netl/serial-charger/pcb/output/layout.pdf

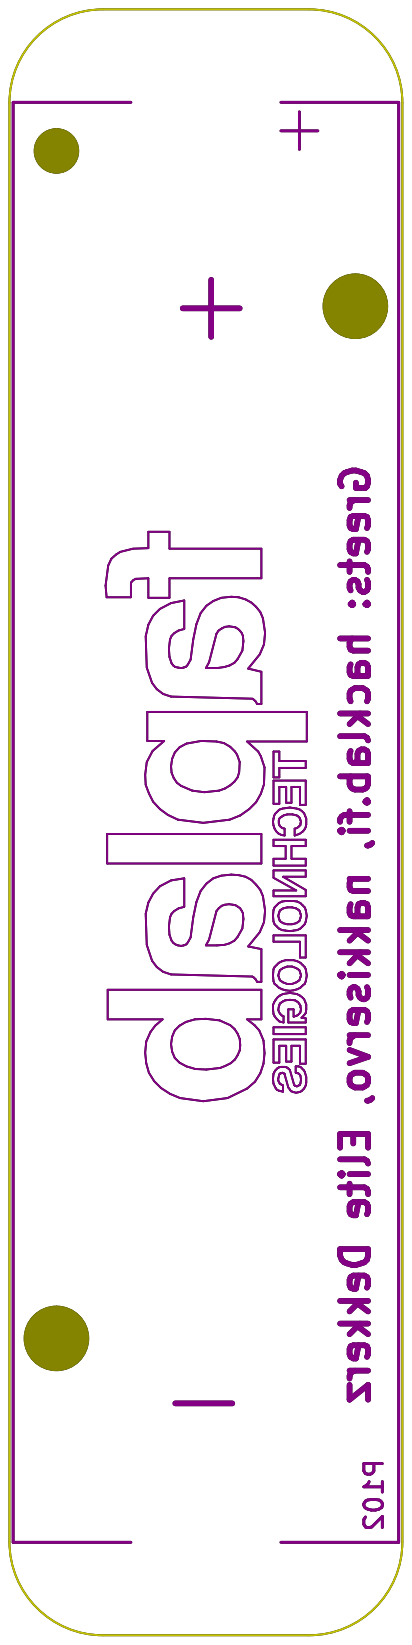
[picture p5: page 1]

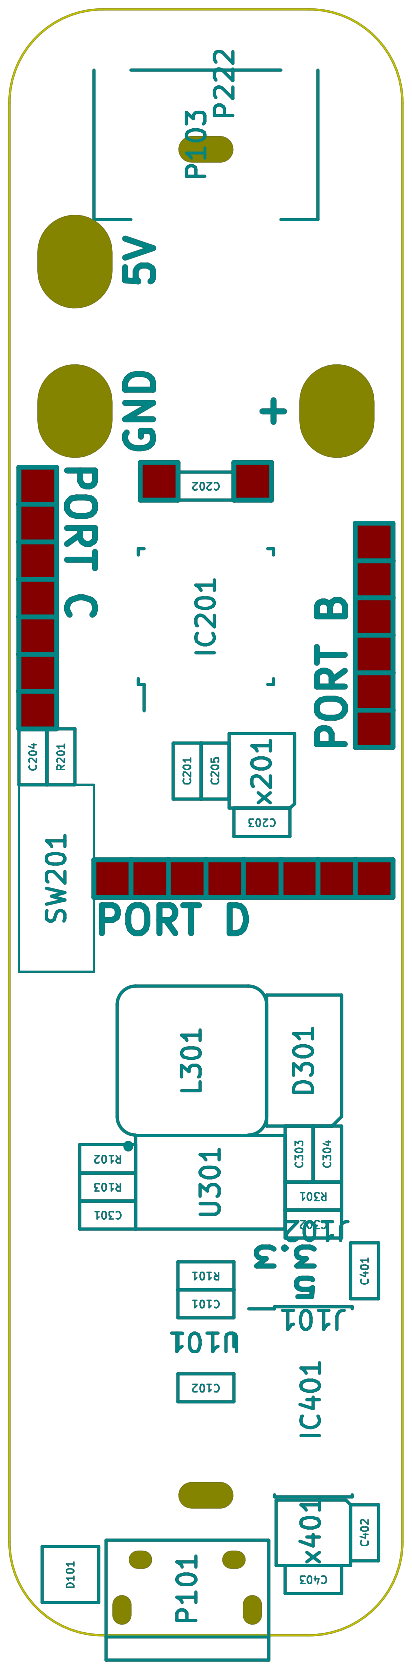
[picture p6: page 2]
