netl/serial-charger/pcb/serial-charger.kicad_pcb

## KiCad design pcb/serial-charger.kicad_pcb (2018-02-05)

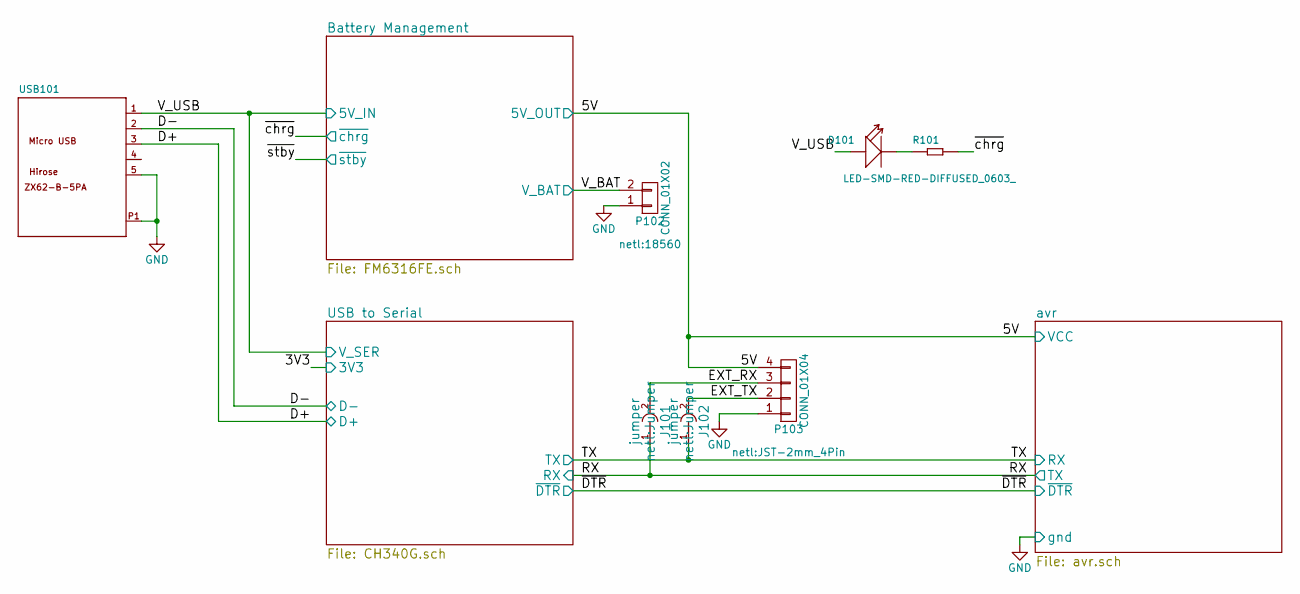
[picture p7: schematic serial-charger.sch]

Parts:
D101: LED-SMD-RED-DIFFUSED_0603_; LED-0603; MPN 19-217-R6C-AL1M2VY-3T
J101, J102: jumper; Jumper
P102: CONN_01X02; 18560
P103: CONN_01X04; JST-2mm_4Pin
R101: SMD-RES-1K-5%-1_10W_0603_; R0603; MPN RC0603JR-071KL
USB101: MICRO-USB-SMD_ZX62-B-5PA_; MICRO-USB5+4P-SMD-0.65-B; MPN ZX62-B-5PA

Connections:
/5V: P103.4; also elsewhere on the board
/D+: USB101.3 (D+); also elsewhere on the board
/D-: USB101.2 (D-); also elsewhere on the board
/EXT_RX: J101.2, P103.3
/EXT_TX: J102.2, P103.2
/RX: J101.1; also elsewhere on the board
/TX: J102.1; also elsewhere on the board
/V_BAT: P102.2; also elsewhere on the board
/V_USB: D101.+, USB101.1 (VBUS); also elsewhere on the board
/~chrg: R101.2; also elsewhere on the board
GND: P102.1, P103.1, USB101.5 (GND), USB101.P1 (SHIELD), USB101.P2 (SHIELD), USB101.P3 (SHIELD), USB101.P4 (SHIELD), USB101.P5 (SHIELD), USB101.P6 (SHIELD); also elsewhere on the board
unnamed: D101.-, R101.1

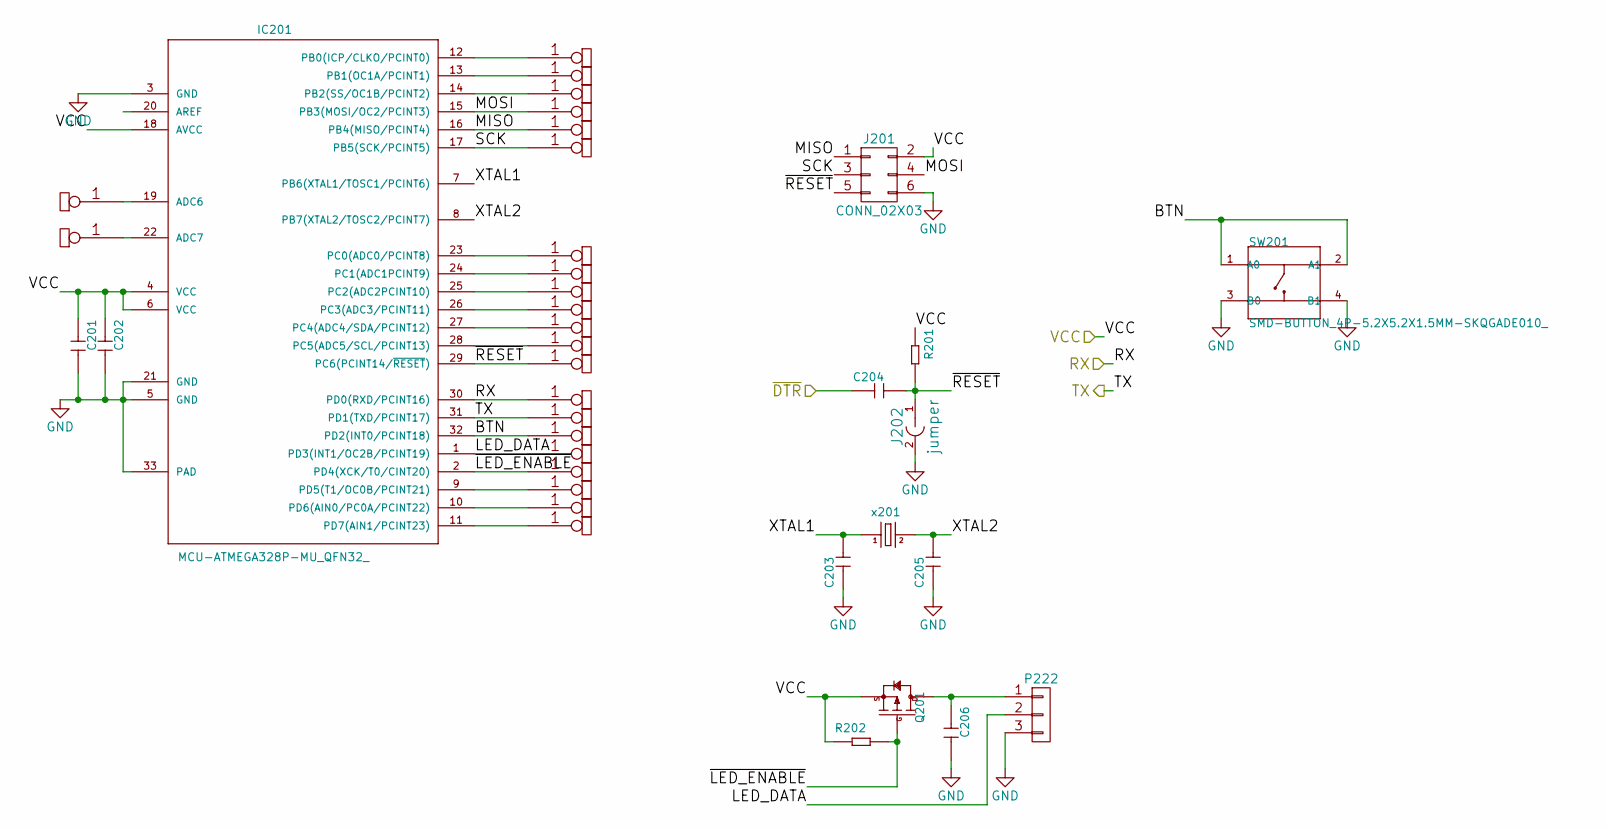
[picture p8: schematic avr.sch]

Parts:
C201, C202, C204: CERAMIC-100NF-50V-10%-X7R_0603_; C0603; MPN CC0603KRX7R9BB104
C203, C205: CERAMIC-22PF-50V-5%-NPO_0603_; C0603; MPN CC0603JRNPO9BN220
C206: CERAMIC-22UF-6.3V-20%-X5R_0805_; C0805; MPN CC0805MKX5R5BB226
IC201: MCU-ATMEGA328P-MU_QFN32_; QFN32G-0.5-5X5MM; MPN ATMEGA328P-MU
J201: CONN_02X03
J202: jumper
P201, P202, P203, P204, P205, P206, P207, P208, P209, P210, P211, P212, P213, P214, P215, P216, P217, P218, P219, P220, P221, P223, P224: CONNECTOR; 1Pin_small
P222: CONN_01X03; SM_3_WIRE
Q201: SMD-MOSFET-P-CH-8V-4.1A-CJ2305_SOT-23_; SOT-23; MPN CJ2305
R201, R202: SMD-RES-10K-1%-1_10W_0603_; R0603; MPN RC0603FR-0710KL
SW201: SMD-BUTTON_4P-5.2X5.2X1.5MM-SKQGADE010_; SW4-SMD-5.2X5.2X1.5MM; MPN SKQGADE010
x201: SMD-CRYSTAL-16MHZ-8PF-20PPM-40R_2P-5.0X3.2MM_; X2-SMD-5.0X3.2X1.3MM; MPN X053201602002

Connections:
/5V: C201.1, C202.1, IC201.4 (VCC), IC201.6 (VCC), IC201.18 (AVCC), J201.2, Q201.2 (S), R201.1, R202.1; also elsewhere on the board
/RX: IC201.31 (PD1(TXD/PCINT17)), P215.1; also elsewhere on the board
/TX: IC201.30 (PD0(RXD/PCINT16)), P214.1; also elsewhere on the board
/avr/BTN: IC201.32 (PD2(INT0/PCINT18)), P216.1, SW201.1 (A0), SW201.2 (A1)
/avr/LED_DATA: IC201.1 (PD3(INT1/OC2B/PCINT19)), P217.1, P222.2
/avr/MISO: IC201.16 (PB4(MISO/PCINT4)), J201.1, P205.1
/avr/MOSI: IC201.15 (PB3(MOSI/OC2/PCINT3)), J201.4, P204.1
/avr/SCK: IC201.17 (PB5(SCK/PCINT5)), J201.3, P206.1
/avr/XTAL1: C203.2, IC201.7 (PB6(XTAL1/TOSC1/PCINT6)), x201.1
/avr/XTAL2: C205.2, IC201.8 (PB7(XTAL2/TOSC2/PCINT7)), x201.2
/avr/~LED_ENABLE: IC201.2 (PD4(XCK/T0/CINT20)), P218.1, Q201.1 (G), R202.2
/avr/~RESET: C204.2, IC201.29 (PC6(PCINT14/~RESET)), J201.5, J202.1, P213.1, R201.2; also elsewhere on the board
/~DTR: C204.1; also elsewhere on the board
GND: C201.2, C202.2, C203.1, C205.1, C206.2, IC201.3 (GND), IC201.5 (GND), IC201.21 (GND), IC201.33 (PAD), J201.6, J202.2, P222.3, SW201.3 (B0), SW201.4 (B1); also elsewhere on the board
unnamed: C206.1, P222.1, Q201.3 (D)
unnamed: IC201.9 (PD5(T1/OC0B/PCINT21)), P219.1
unnamed: IC201.10 (PD6(AIN0/PC0A/PCINT22)), P220.1
unnamed: IC201.11 (PD7(AIN1/PCINT23)), P221.1
unnamed: IC201.12 (PB0(ICP/CLKO/PCINT0)), P201.1
unnamed: IC201.13 (PB1(OC1A/PCINT1)), P202.1
unnamed: IC201.14 (PB2(SS/OC1B/PCINT2)), P203.1
unnamed: IC201.19 (ADC6), P223.1
unnamed 37: IC201.20 (AREF); also elsewhere on the board
unnamed: IC201.22 (ADC7), P224.1
unnamed: IC201.23 (PC0(ADC0/PCINT8)), P207.1
unnamed: IC201.24 (PC1(ADC1PCINT9)), P208.1
unnamed: IC201.25 (PC2(ADC2PCINT10)), P209.1
unnamed: IC201.26 (PC3(ADC3/PCINT11)), P210.1
unnamed: IC201.27 (PC4(ADC4/SDA/PCINT12)), P211.1
unnamed: IC201.28 (PC5(ADC5/SCL/PCINT13)), P212.1

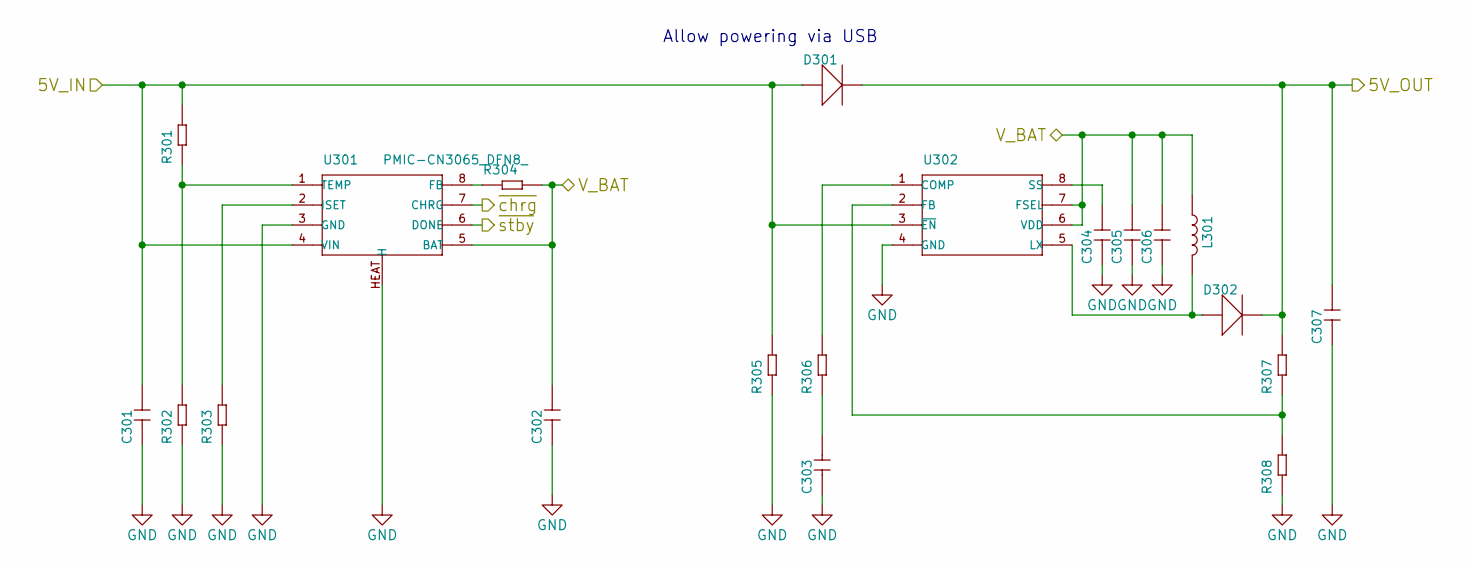
[picture p9: schematic FM6316FE.sch]

Parts:
C301, C302: CERAMIC-4.7UF-10V-10%-X5R_0603_; C0603; MPN CC0603KRX5R6BB475
C303: CERAMIC-4.7NF-50V-10%-X7R_0603_; C0603; MPN CC0603KRX7R9BB472
C304: CERAMIC-33NF-50V-10%-X7R_0603_; C0603; MPN CC0603KRX7R9BB333
C305: CERAMIC-100NF-50V-10%-X7R_0603_; C0603; MPN CC0603KRX7R9BB104
C306, C307: CERAMIC-22UF-6.3V-20%-X5R_0805_; C0805; MPN CC0805MKX5R5BB226
D301, D302: SMD-DIODE-SCHOTTKY-28V-5A_DO-214AA_; DO-214AA; MPN SS54B
L301: SMD-INDUCTOR-10UH-20%_2P-6X6MM_; SMD-2P-L6.0XW6.0XH3.0MM; MPN CSAB0630-100M
R301, R308: SMD-RES-10K-1%-1_10W_0603_; R0603; MPN RC0603FR-0710KL
R302: SMD-RES-0R-5%-1_10W_0603_; R0603; MPN RC0603JR-070RL
R303: SMD-RES-3.6R-5%-1_10W_0603_; R0603; MPN RC0603JR-073R6L
R304: SMD-RES-0R-5%-1_10W_0603_; R_0603; MPN RC0603JR-070RL
R305: SMD-RES-10K-5%-1_10W_0603_; R0603; MPN RC0603JR-0710KL
R306: SMD-RES-3.9K-5%-1_10W_0603_; R0603; MPN RC0603JR-073K9L
R307: SMD-RES-30K-1%-1_10W_0603_; R0603; MPN RC0603FR-0730KL
U301: PMIC-CN3065_DFN8_; DFN8G-0.5-3X3MM; MPN CN3065
U302: PMIC-ISL97516IUZ-TK_MSOP8_; MSOP8-0.65-3X3MM; MPN ISL97516IUZ-TK

Connections:
/5V: C307.2, D301.-, D302.-, R307.2; also elsewhere on the board
/V_BAT: C302.2, C305.2, C306.2, L301.1, R304.2, U301.5 (BAT), U302.6 (VDD), U302.7 (FSEL); also elsewhere on the board
/V_USB: C301.2, D301.+, R301.2, R305.2, U301.4 (VIN), U302.3 (~EN); also elsewhere on the board
/~chrg: U301.7 (CHRG); also elsewhere on the board
/~stby: U301.6 (DONE)
GND: C301.1, C302.1, C303.1, C304.1, C305.1, C306.1, C307.1, R302.1, R303.1, R305.1, R308.1, U301.3 (GND), U301.HEAT (H), U302.4 (GND); also elsewhere on the board
unnamed: C303.2, R306.1
unnamed: C304.2, U302.8 (SS)
unnamed: D302.+, L301.2, U302.5 (LX)
unnamed: R301.1, R302.2, U301.1 (TEMP)
unnamed: R303.2, U301.2 (ISET)
unnamed: R304.1, U301.8 (FB)
unnamed: R306.2, U302.1 (COMP)
unnamed: R307.1, R308.2, U302.2 (FB)

Notes on the sheet:
Allow powering via USB

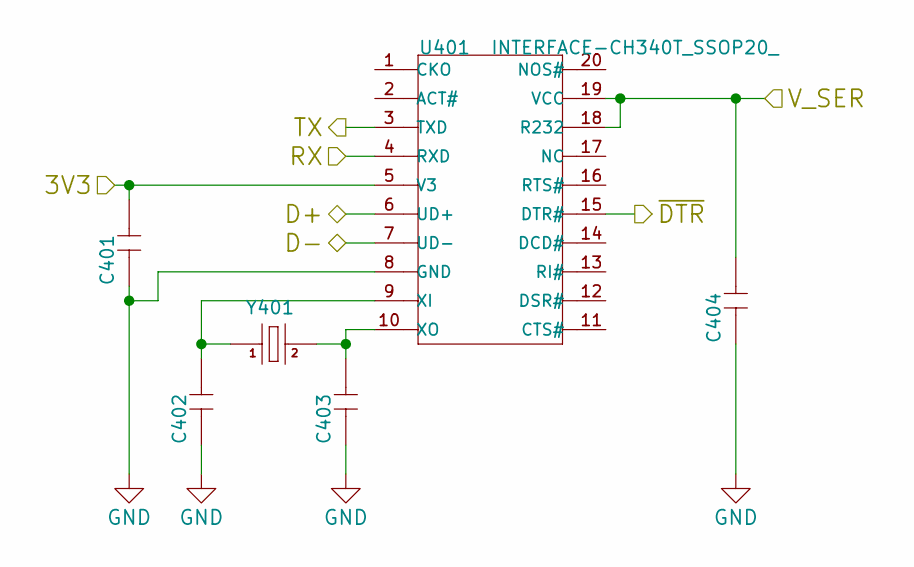
[picture p10: schematic CH340G.sch]

Parts:
C401, C404: CERAMIC-100NF-50V-10%-X7R_0603_; C0603; MPN CC0603KRX7R9BB104
C402, C403: CERAMIC-22PF-50V-5%-NPO_0603_; C0603; MPN CC0603JRNPO9BN220
U401: INTERFACE-CH340T_SSOP20_; TSSOP20-0.65-6.5X4.4MM; MPN CH340T
Y401: SMD-CRYSTAL-12MHZ-20PF-20PPM-40R_2P-5.0X3.2MM_; X2-SMD-5.0X3.2X1.3MM; MPN 5032_2P

Connections:
/3V3: C401.2, U401.5 (V3)
/D+: U401.6 (UD+); also elsewhere on the board
/D-: U401.7 (UD-); also elsewhere on the board
/RX: U401.4 (RXD); also elsewhere on the board
/TX: U401.3 (TXD); also elsewhere on the board
/V_USB: C404.2, U401.18 (R232), U401.19 (VCC); also elsewhere on the board
/~DTR: U401.15 (DTR#); also elsewhere on the board
GND: C401.1, C402.1, C403.1, C404.1, U401.8 (GND); also elsewhere on the board
unnamed: C402.2, U401.9 (XI), Y401.1
unnamed: C403.2, U401.10 (XO), Y401.2

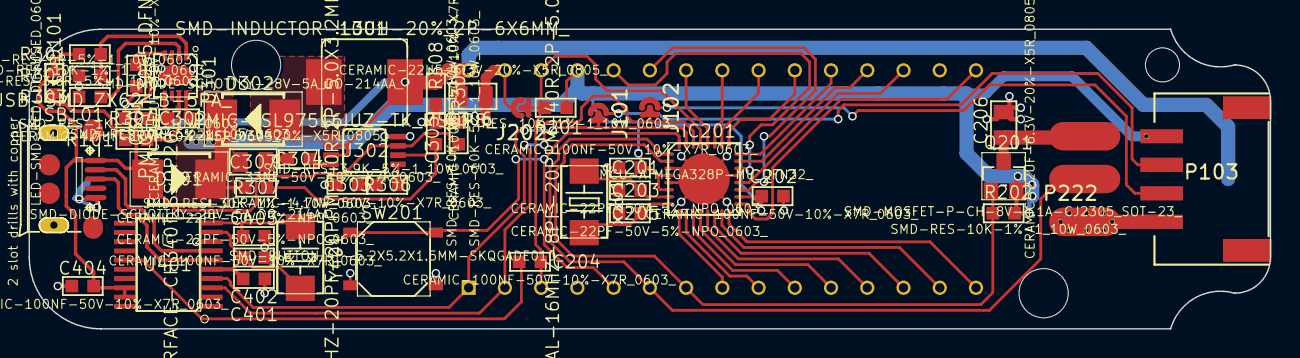
[picture p11: board serial-charger.kicad_pcb from above]

Board: 2 copper layers, 87.0 x 21.0 mm, 77 parts (1 on the bottom side), 49 nets.

Other parts of the board:
JP11, JP11#2, JP11#3, JP11#4, JP11#5, JP11#6: CONN_01X01; 1Pin_through
P213#2: CONNECTOR; 1Pin_through

Their connections:
/5V: JP11#3.1; also elsewhere on the board
/V_BAT: JP11.1; also elsewhere on the board
/avr/~RESET: P213#2.1; also elsewhere on the board
GND: JP11#2.1, JP11#5.1; also elsewhere on the board
unnamed 37: JP11#4.1; also elsewhere on the board
