netl/serial-charger/(commit log)

2016-09-01 started schema
    [badge.sch]
2016-09-02 first complete version
    [badge.kicad_pcb, badge.sch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]
2016-09-17 remved logic level shifter and updated component values
    [badge.sch]
2016-10-08 updated layout to match schema
    [badge.kicad_pcb, badge.sch]
2016-10-16 removed 3V3 selection. cleaned up layout
    [badge.kicad_pcb, badge.sch]
2016-10-16 renamed project files
    [serial-charger.kicad_pcb, serial-charger.sch]
2016-10-16 cleanup, renamed output files to match kicad output
    [badge.kicad_pcb, badge.sch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]
2016-10-16 disabled thermal shutoff from charger
    [serial-charger.kicad_pcb, serial-charger.sch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]
2016-10-16 updated the other gerber files too. doh.
    [serial-charger-B.Cu.gbl, serial-charger-B.Mask.gbs, serial-charger-Edge.Cuts.gm1, serial-charger-F.Cu.gtl, serial-charger-F.Mask.gts, serial-charger.drl]
2017-02-28 changed regulator and jumpers
    [serial-charger.sch]
2017-03-02 changed charger
    [serial-charger.sch]
2017-03-04 partyhat edition, with built in avr and li-ion holder
    [avr.sch, serial-charger.kicad_pcb, serial-charger.sch]
2017-03-05 layout mostly done
    [serial-charger.kicad_pcb, serial-charger.sch]
2017-03-05 first prototype
    [serial-charger-B.Cu.gbl, serial-charger-B.Mask.gbs, serial-charger-B.SilkS.gbo, serial-charger-Edge.Cuts.gm1, serial-charger-F.Cu.gtl, serial-charger-F.Mask.gts, serial-charger-F.SilkS.gto, serial-charger-NPTH.drl]
2017-03-26 changed to hierarchial layout in schematics
    [CH340G.sch, FM6316FE.sch, avr.sch, serial-charger.sch]
2017-03-26 added documentation, moved gerber files to a separate directory
    [serial-charger-B.Cu.gbl, serial-charger-B.Mask.gbs, serial-charger-B.SilkS.gbo, serial-charger-Edge.Cuts.gm1, serial-charger-F.Cu.gtl, serial-charger-F.Mask.gts, serial-charger-F.SilkS.gto, serial-charger-NPTH.drl]
2017-04-04 changed LED and boost converters Diode footprints. renumbered components
    [CH340G.sch, FM6316FE.sch, _saved_serial-charger.sch, avr.sch]
2017-04-04 removed kicad backup file
    [_saved_serial-charger.sch]
2017-05-18 changed mcu to the correct one. redid layout
    [BOM.csv, CH340G.sch, avr.sch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]
2017-06-14 updated component values
    [avr.sch]
2017-06-14 fixed short circuits caused by oversized breakout pads
    [serial-charger.kicad_pcb]
2017-06-14 centered battery tab connectors, reworked layout to match it
    [FM6316FE.sch, avr.sch, serial-charger.kicad_pcb, serial-charger.sch]
2017-06-18 cleaned up component values, rebuilt BOM
    [BOM.csv, FM6316FE.sch, serial-charger.kicad_pcb]
2017-06-18 added branding, updated documentation and gerber
    [serial-charger-B.Cu.gbl, serial-charger-B.Mask.gbs, serial-charger-B.SilkS.gbo, serial-charger-Edge.Cuts.gm1, serial-charger-F.Cu.gtl, serial-charger-F.Mask.gts, serial-charger-F.SilkS.gto, serial-charger-NPTH.drl]
2018-01-08 reworked bms and mcu to use seeed components
    [CH340G.sch, FM6316FE.sch, avr.sch, serial-charger.kicad_pcb, serial-charger.sch]
2018-01-09 added spi header for avr
    [avr.sch]
2018-01-09 finished swapping parts, started layout
    [CH340G.sch, FM6316FE.sch, avr.sch, serial-charger.kicad_pcb, serial-charger.sch]
2018-01-10 added led strip power control, minor adjustments to layout
    [avr.sch, serial-charger.kicad_pcb]
2018-01-27 boost circuit layout mostly done
    [serial-charger.kicad_pcb]
2018-02-05 added button, capacitor to led strip power and jumpers to external rx/tx. everything layed out and connected
    [CH340G.sch, FM6316FE.sch, avr.sch, serial-charger.kicad_pcb, serial-charger.sch]
